trupples/thesis/latex/emg ap.pdf

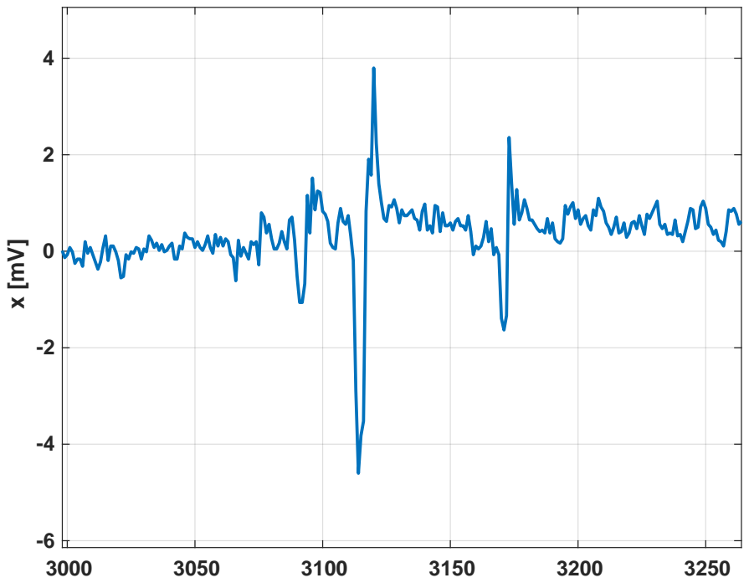
[picture p22: figure]
