trupples/thesis/assets/Pasted image 20240115170251.png

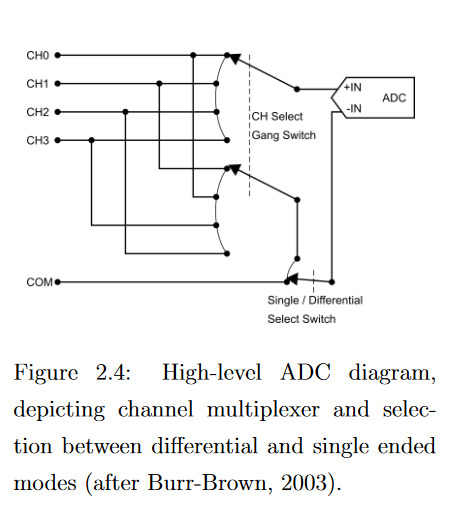
assets/Pasted image 20240115170251.png
