trupples/thesis/latex/agcl-dry.JPG

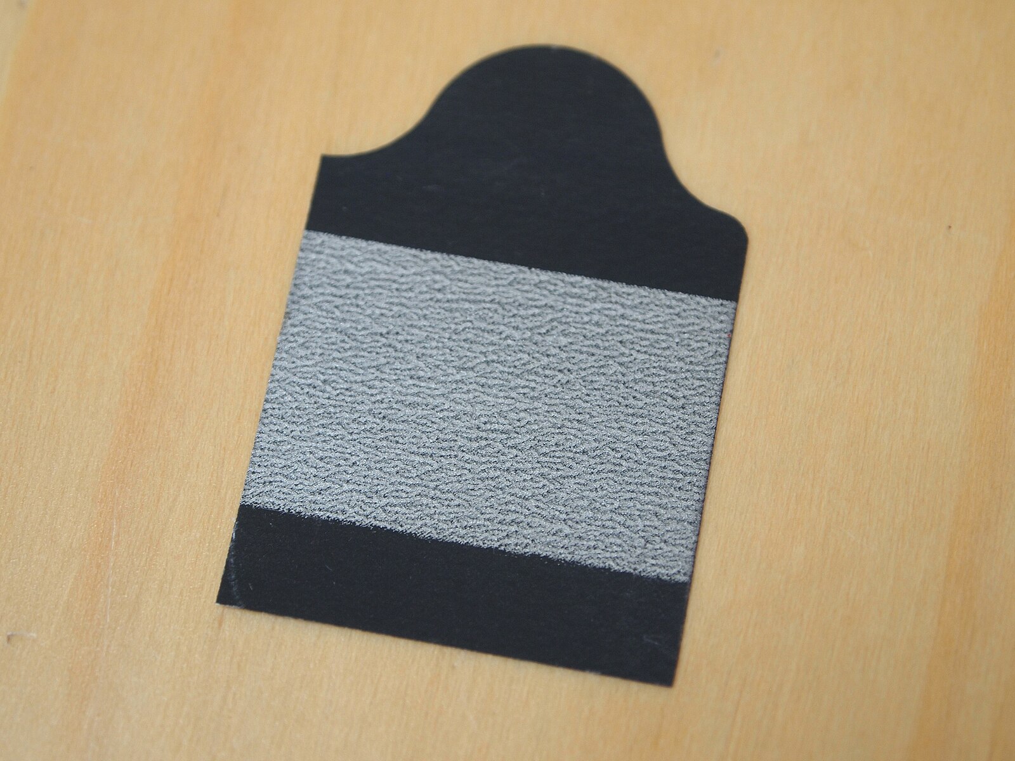
latex/agcl-dry.JPG
