trupples/thesis/latex/antet.png

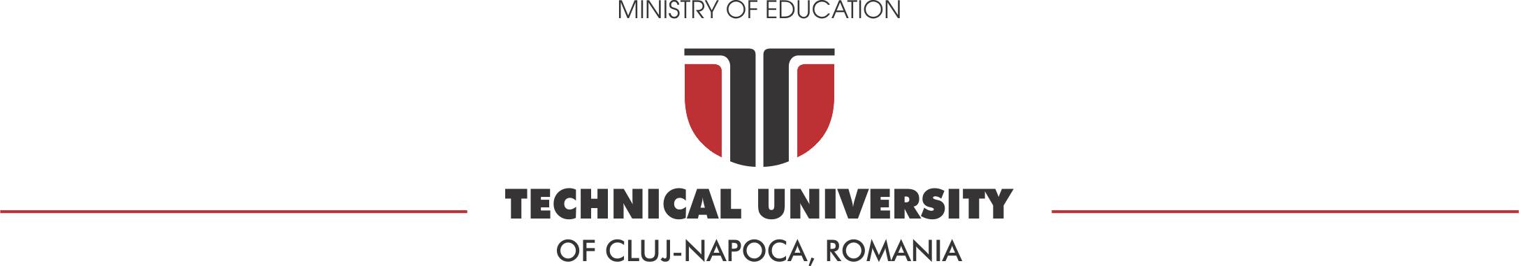
latex/antet.png
