trupples/thesis/latex/emg muap.pdf

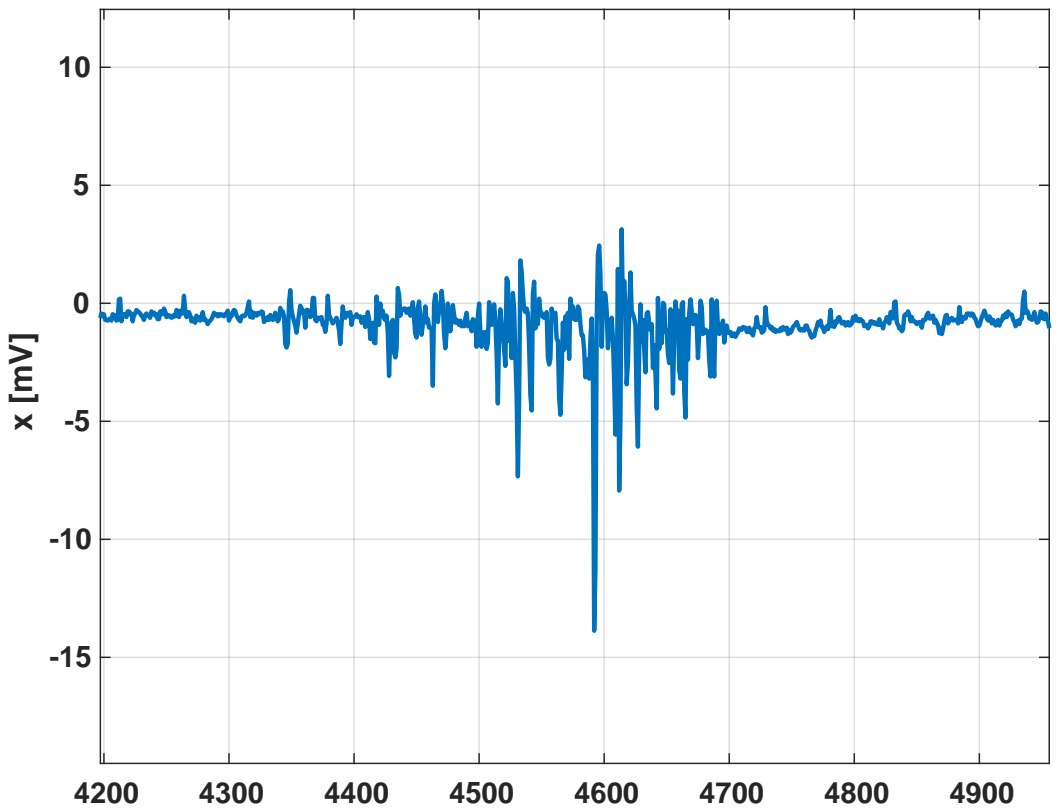
[picture p26: page 1]
