trupples/thesis/hardware/diff-amp/diff-amp.kicad_pcb

## KiCad design hardware/diff-amp/diff-amp.kicad_pcb (2024-09-02)

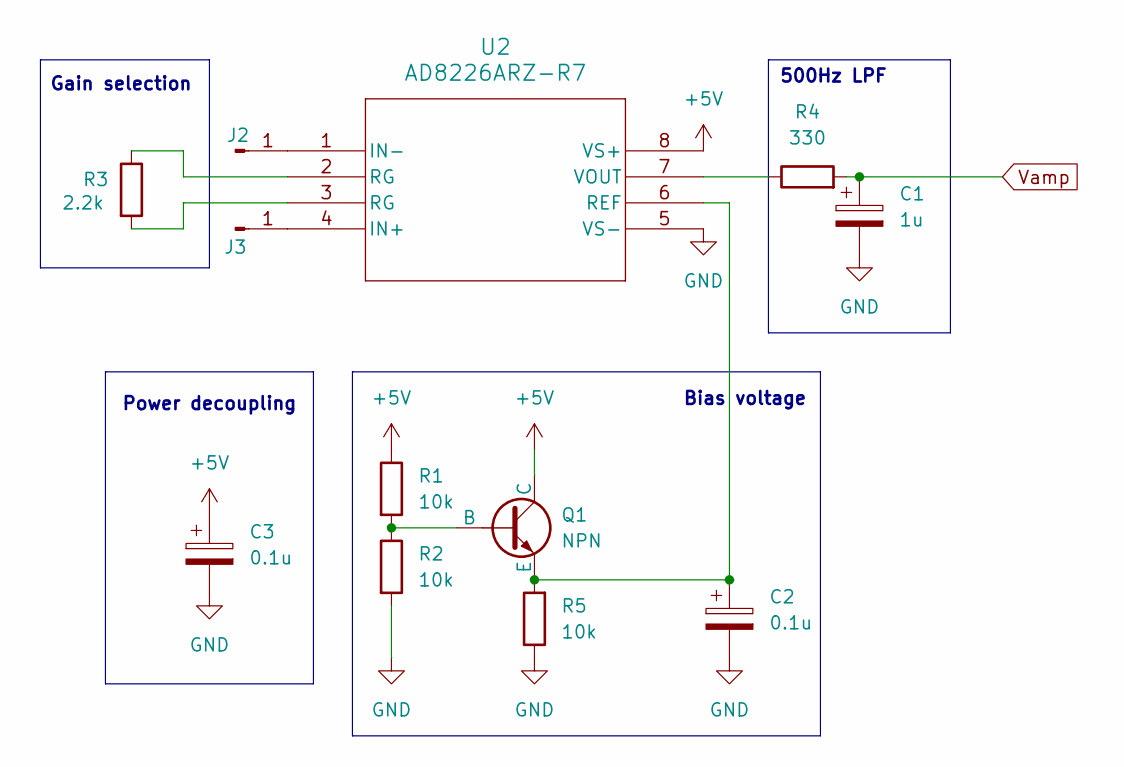
[picture p27: schematic diff-amp.kicad_sch]

Parts:
C1: 1u; CP_Radial_D4.0mm_P2.00mm
C2, C3: 0.1u; CP_Radial_D5.0mm_P2.50mm
J2, J3: Conn_01x01_Pin; SolderWirePad_1x01_SMD_5x10mm
Q1: NPN; TO-92L_Inline_Wide
R1, R2, R5: 10k; R_Axial_DIN0207_L6.3mm_D2.5mm_P2.54mm_Vertical
R3: 2.2k; R_Axial_DIN0207_L6.3mm_D2.5mm_P7.62mm_Horizontal
R4: 330; R_Axial_DIN0207_L6.3mm_D2.5mm_P10.16mm_Horizontal
U2: AD8226ARZ-R7; DIP-8_W7.62mm_Socket

Connections:
+5V: C3.1, Q1.1 (C), R1.1, U2.8 (VS+); also elsewhere on the board
GND: C1.2, C2.2, C3.2, R2.2, R5.1, U2.5 (VS-); also elsewhere on the board
unnamed: J2.1, U2.1 (IN-)
unnamed: J3.1, U2.4 (IN+)
unnamed: Q1.2 (B), R1.2, R2.1
unnamed: C2.1, Q1.3 (E), R5.2, U2.6 (REF)
unnamed: R3.1, U2.2 (RG)
unnamed: R3.2, U2.3 (RG)
unnamed: R4.1, U2.7 (VOUT)
Vout: C1.1, R4.2; also elsewhere on the board

Notes on the sheet:
500Hz LPF
Power decoupling
Gain selection
Bias voltage

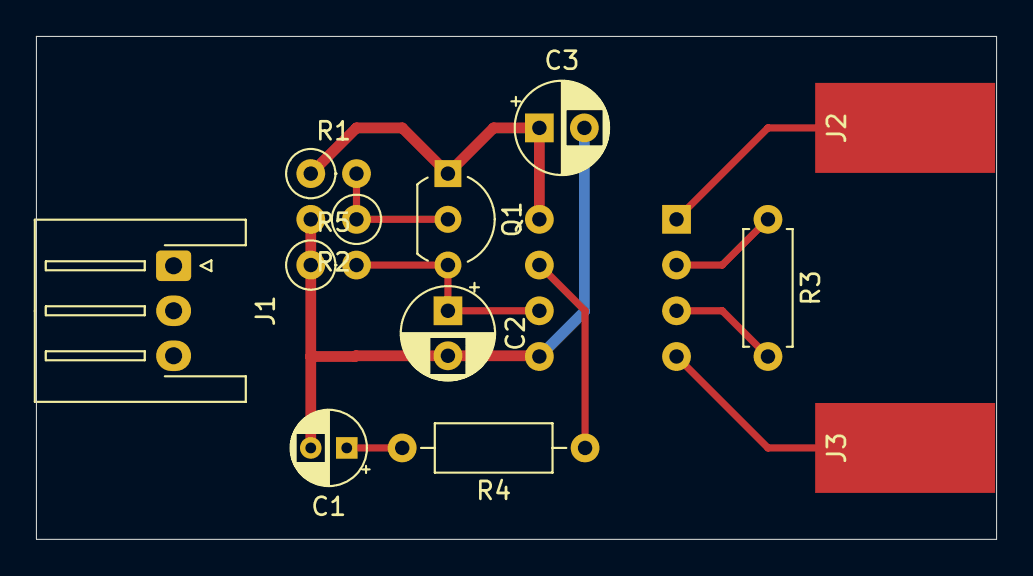
[picture p28: board diff-amp.kicad_pcb from above]

Board: 2 copper layers, 53.3 x 27.9 mm, 13 parts (1 on the bottom side), 10 nets.

Other parts of the board:
J1: Conn_01x03_Socket; JST_XH_S3B-XH-A-1_1x03_P2.50mm_Horizontal

Their connections:
+5V: J1.1; also elsewhere on the board
GND: J1.2; also elsewhere on the board
Vout: J1.3; also elsewhere on the board
