trupples/thesis/hardware/myo-hub/myo-hub.kicad_pcb

## KiCad design hardware/myo-hub/myo-hub.kicad_pcb (2024-04-29)

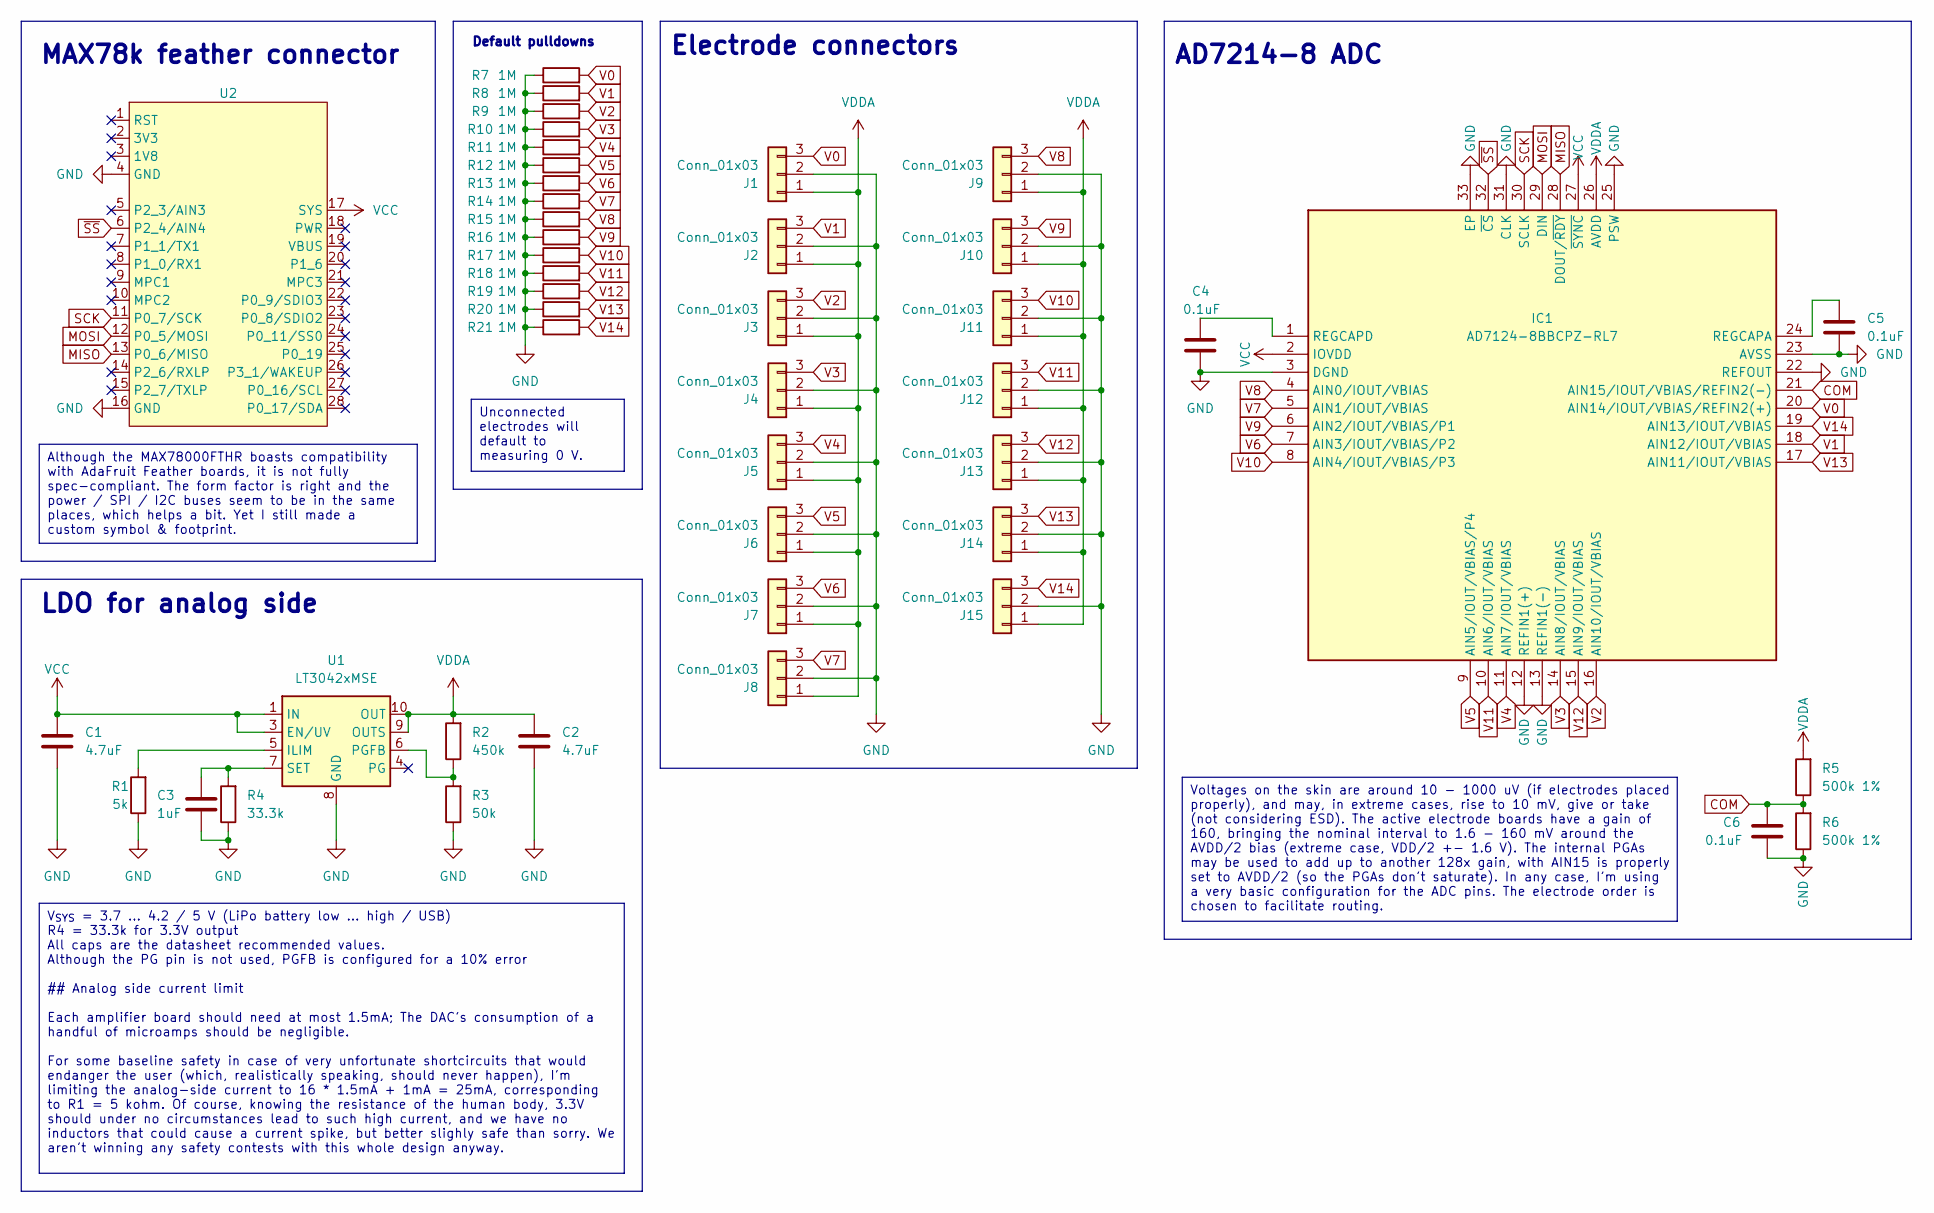
[picture p29: schematic myo-hub.kicad_sch, 15 Channel EMG feather wing]

Parts:
C1, C2: 4.7uF; C_0603_1608Metric_Pad1.08x0.95mm_HandSolder
C3: 1uF; C_0603_1608Metric_Pad1.08x0.95mm_HandSolder
C4, C5, C6: 0.1uF; C_0603_1608Metric_Pad1.08x0.95mm_HandSolder
IC1: AD7124-8BBCPZ-RL7; QFN50P500X500X100-33N-D; Mouser Part Number 584-AD7124-8BBCPZRL7
J1, J2, J3, J4, J5, J6, J7, J8, J9, J10, J11, J12, J13, J14, J15: Conn_01x03; JST_PH_B3B-PH-K_1x03_P2.00mm_Vertical
R1: 5k; R_0603_1608Metric_Pad0.98x0.95mm_HandSolder
R2: 450k; R_0603_1608Metric_Pad0.98x0.95mm_HandSolder
R3: 50k; R_0603_1608Metric_Pad0.98x0.95mm_HandSolder
R4: 33.3k; R_0603_1608Metric_Pad0.98x0.95mm_HandSolder
R5, R6: 500k 1%; R_0603_1608Metric_Pad0.98x0.95mm_HandSolder
R7, R8, R9, R10, R11, R12, R13, R14, R15, R16, R17, R18, R19, R20, R21: 1M; R_0603_1608Metric_Pad0.98x0.95mm_HandSolder
U1: LT3042xMSE; MSOP-10-1EP_3x3mm_P0.5mm_EP1.68x1.88mm
U2: MAX78000FTHR_Socket

Connections:
COM: C6.1, IC1.21 (AIN15/IOUT/VBIAS/REFIN2(-)), R5.1, R6.2
GND: C1.2, C2.2, C3.2, C4.1, C5.2, C6.2, IC1.3 (DGND), IC1.12 (REFIN1(+)), IC1.13 (REFIN1(-)), IC1.22 (REFOUT), IC1.23 (AVSS), IC1.25 (PSW), IC1.31 (CLK), IC1.33 (EP), J1.2, J2.2, J3.2, J4.2, J5.2, J6.2, J7.2, J8.2, J9.2, J10.2, J11.2, J12.2, J13.2, J14.2, J15.2, R1.1, R3.1, R4.1, R6.1, R7.1, R8.1, R9.1, R10.1, R11.1, R12.1, R13.1, R14.1, R15.1, R16.1, R17.1, R18.1, R19.1, R20.1, R21.1, U1.8 (GND), U1.11 (GND), U2.4 (GND), U2.16 (GND)
MISO: IC1.28 (DOUT/~RDY), U2.13 (P0_6/MISO)
MOSI: IC1.29 (DIN), U2.12 (P0_5/MOSI)
unnamed: C5.1, IC1.24 (REGCAPA)
unnamed: C4.2, IC1.1 (REGCAPD)
unnamed: R1.2, U1.5 (ILIM)
unnamed: R2.1, R3.2, U1.6 (PGFB)
unnamed: C3.1, R4.2, U1.7 (SET)
SCK: IC1.30 (SCLK), U2.11 (P0_7/SCK)
V0: IC1.20 (AIN14/IOUT/VBIAS/REFIN2(+)), J1.3, R7.2
V1: IC1.18 (AIN12/IOUT/VBIAS), J2.3, R8.2
V2: IC1.16 (AIN10/IOUT/VBIAS), J3.3, R9.2
V3: IC1.14 (AIN8/IOUT/VBIAS), J4.3, R10.2
V4: IC1.11 (AIN7/IOUT/VBIAS), J5.3, R11.2
V5: IC1.9 (AIN5/IOUT/VBIAS/P4), J6.3, R12.2
V6: IC1.7 (AIN3/IOUT/VBIAS/P2), J7.3, R13.2
V7: IC1.5 (AIN1/IOUT/VBIAS), J8.3, R14.2
V8: IC1.4 (AIN0/IOUT/VBIAS), J9.3, R15.2
V9: IC1.6 (AIN2/IOUT/VBIAS/P1), J10.3, R16.2
V10: IC1.8 (AIN4/IOUT/VBIAS/P3), J11.3, R17.2
V11: IC1.10 (AIN6/IOUT/VBIAS), J12.3, R18.2
V12: IC1.15 (AIN9/IOUT/VBIAS), J13.3, R19.2
V13: IC1.17 (AIN11/IOUT/VBIAS), J14.3, R20.2
V14: IC1.19 (AIN13/IOUT/VBIAS), J15.3, R21.2
VCC: C1.1, IC1.2 (IOVDD), IC1.27 (~SYNC), U1.1 (IN), U1.2 (IN), U1.3 (EN/UV), U2.17 (SYS)
VDDA: C2.1, IC1.26 (AVDD), J1.1, J2.1, J3.1, J4.1, J5.1, J6.1, J7.1, J8.1, J9.1, J10.1, J11.1, J12.1, J13.1, J14.1, J15.1, R2.2, R5.2, U1.9 (OUTS), U1.10 (OUT)
~SS: IC1.32 (~CS), U2.6 (P2_4/AIN4)

Notes on the sheet:
Voltages on the skin are around 10 - 1000 uV (if electrodes placed properly), and may, in extreme cases, rise to 10 mV, give or take (not considering ESD). The active electrode boards have a gain of 160, bringing the nominal interval to 1.6 - 160 mV around the AVDD/2 bias (extreme case, VDD/2 +- 1.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
Although the MAX78000FTHR boasts compatibility with AdaFruit Feather boards, it is not fully spec-compliant. The form factor is right and the power / SPI / I2C buses seem to be in the same places, which helps a bit. Yet I still made a custom symbol & footprint.
V_{SYS} = 3.7 ... 4.2 / 5 V (LiPo battery low ... high / USB) R4 = 33.3k for 3.3V output All caps are the datasheet recommended values. Although the PG pin is not used, PGFB is configured for a 10% error ## Analog side current limit Each amplifier board should need at most 1.5mA; The DAC's consumpt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
Unconnected electrodes will default to measuring 0 V.
Electrode connectors
Default pulldowns
LDO for analog side
MAX78k feather connector
AD7214-8 ADC

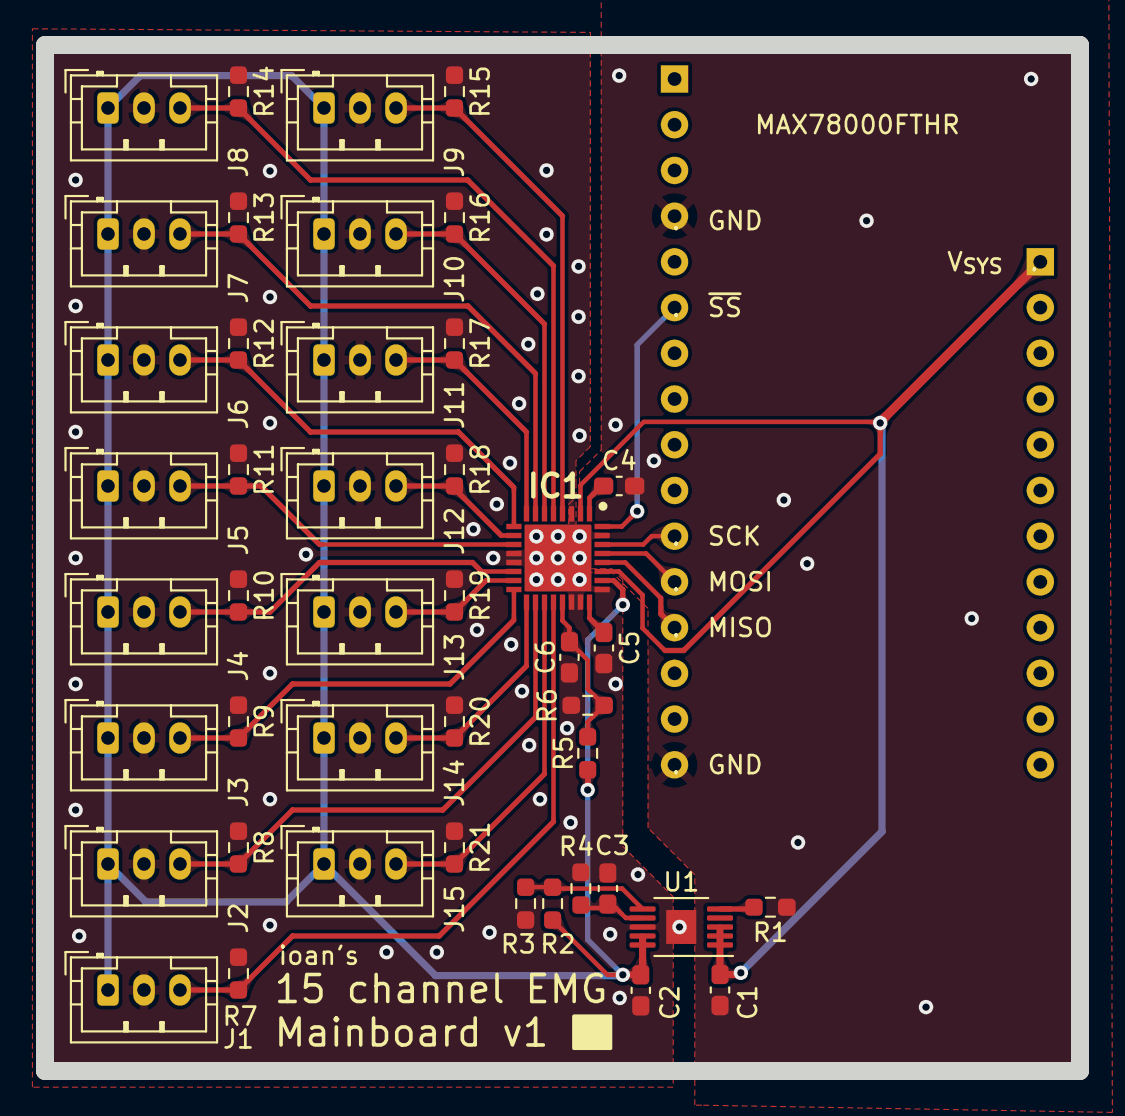
[picture p30: board myo-hub.kicad_pcb from above]

Board: 2 copper layers, 57.5 x 57.0 mm, 45 parts (0 on the bottom side), 28 nets.
