trupples/thesis/hardware/myo-amp/myo-amp.kicad_pcb

## KiCad design hardware/myo-amp/myo-amp.kicad_pcb (2024-04-24)

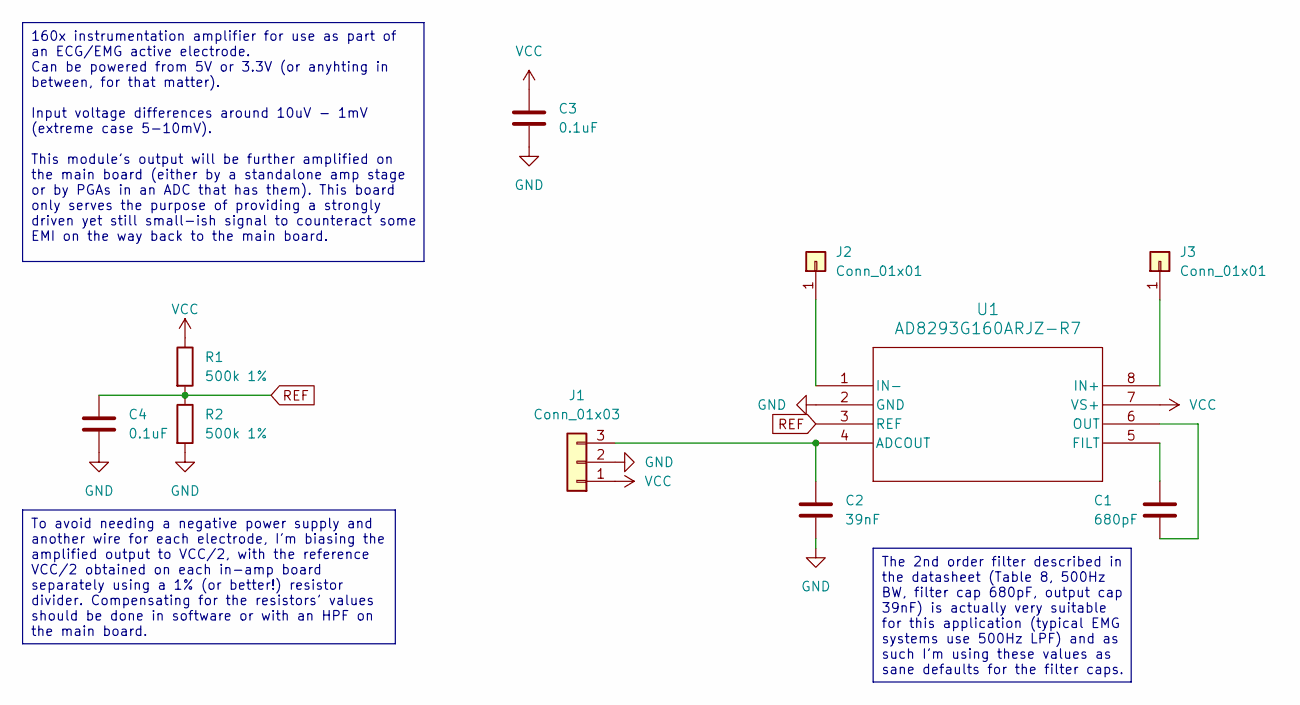
[picture p31: schematic myo-amp.kicad_sch, 160x in-amp for EMG active electrode]

Parts:
C1: 680pF; C_0603_1608Metric_Pad1.08x0.95mm_HandSolder
C2: 39nF; C_0603_1608Metric_Pad1.08x0.95mm_HandSolder
C3, C4: 0.1uF; C_0603_1608Metric_Pad1.08x0.95mm_HandSolder
J1: Conn_01x03; JST_PH_S3B-PH-K_1x03_P2.00mm_Horizontal
J2, J3: Conn_01x01; SolderWire-0.5sqmm_1x01_D0.9mm_OD2.1mm_Relief
R1, R2: 500k 1%; R_0603_1608Metric_Pad0.98x0.95mm_HandSolder
U1: AD8293G160ARJZ-R7; SOT-23-8_Handsoldering

Connections:
+5V: C3.1, J1.1, R1.1, U1.7 (VS+)
GND: C2.2, C3.2, C4.2, J1.2, R2.2, U1.2 (GND)
unnamed: C2.1, J1.3, U1.4 (ADCOUT)
unnamed: J2.1, U1.1 (IN-)
unnamed: J3.1, U1.8 (IN+)
unnamed: C1.2, U1.5 (FILT)
unnamed: C1.1, U1.6 (OUT)
REF: C4.1, R1.2, R2.1, U1.3 (REF)

Notes on the sheet:
The 2nd order filter described in the datasheet (Table 8, 500Hz BW, filter cap 680pF, output cap 39nF) is actually very suitable for this application (typical EMG systems use 500Hz LPF) and as such I'm using these values as sane defaults for the filter caps.
To avoid needing a negative power supply and another wire for each electrode, I'm biasing the amplified output to VCC/2, with the reference VCC/2 obtained on each in-amp board separately using a 1% (or better!) resistor divider. Compensating for the resistors' values should be done in software or w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
160x instrumentation amplifier for use as part of an ECG/EMG active electrode. Can be powered from 5V or 3.3V (or anyhting in between, for that matter). Input voltage differences around 10uV - 1mV (extreme case 5-10mV). This module's output will be further amplified on the main board (either by a s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

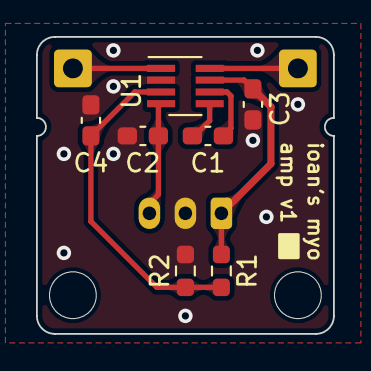
[picture p32: board myo-amp.kicad_pcb from above]

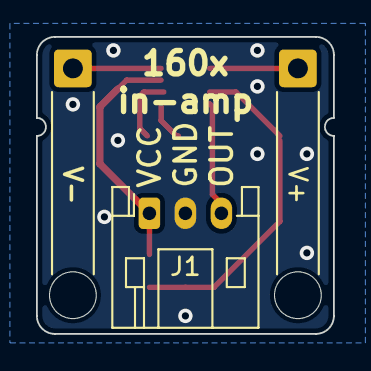
[picture p33: board myo-amp.kicad_pcb from below]

Board: 2 copper layers, 16.5 x 16.5 mm, 10 parts (3 on the bottom side), 8 nets.
