trupples/thesis/(commit log)

2024-04-24 Amplifier board hardware for review
    [myo-amp.kicad_pcb, myo-amp.kicad_sch]
2024-04-24 WIP main feather wings
    One of the main issues to address would be that I wrongly (and greedily) picked the AD4310 which is rather limited samplerate-wise. Considering changing to the AD7124-8 for 15 channels
    [myo-hub.kicad_pcb, myo-hub.kicad_sch]
2024-04-24 Change ADC to AD7124-8
    [myo-hub.kicad_pcb, myo-hub.kicad_sch]
2024-04-24 Mainboard silkscreen, ground vias, routing tweaks
    [myo-hub.kicad_pcb]
2024-04-24 Tidy mainboard schematic
    [myo-hub.kicad_sch]
2024-04-24 Mainboard layout cleanup
    [myo-hub.kicad_pcb, myo-hub.kicad_sch]
2024-04-29 Add pseudo-differential reference circuit
    This in turn enables us to use the PGAs without saturating them.
    With a zero reference, we can only use gain=1, because even gain=2
    would result in a AVDD/2*2 = AVDD voltage at the PGA's output with
    zero! input.
    [myo-hub.kicad_pcb, myo-hub.kicad_sch]
2024-04-29 Move all components to primary side
    [myo-hub.kicad_pcb]
2024-05-24 Create custom EXG IIO device description
2024-05-24 Remove README copied from SPI demo
2024-06-02 Logs 2024-06-03 v incomplete
2024-06-17 GPIO IRQ attempt to get /RDY. Fail :(
    [iio_ad4114_exg.c, main.c, parameters.h]
2024-06-18 Half working timer interrupt trigger
2024-06-20 Bodges to try to get the hardware timer to work
    IIO resets the IRQ controller when starting up (iio_app_init > print_uart_hello_message > no_os_uart_remove > max_uart_remove > no_os_irq_ctrl_remove) which is a bummer. Reference count logic is broken (can never know if you.re given an invalid non-null pointer or an actual initialized object when initializing). Even without the remove calls, the IRQ controller is reinitialized immediately after by uart_init. Maybe the UART code is the actual issue, but in any case it.s blocking be bad...
    [common_data.c, iio_ad4114_exg.c, main.c, parameters.h]
2024-08-21 physiology finally + a little signal chain stuff
2024-08-31 Preamp board DONE and written up GOD
    [preamp_bode_great_success.csv]
2024-09-01 99% final firmware
    Only improvement point would be some filtering but it seems like thats not needed
2024-09-01 iio demos DONE
    [ecg1_author_has_rbbb_lmao.csv, ecg3.csv, emg6.csv]
